GomezThiago123/LlaveTrack/README.md

# LlavesUBA

(Antes se llamaba LlaveTrack: los nombres internos, como la carpeta y los tópicos MQTT, siguen así.)

> Qué es y cómo funciona el sistema, y el estado de cada historia: [documentacion.md](documentacion.md). Tareas abiertas: [PENDIENTES.md](PENDIENTES.md).

Sistema para retirar y devolver las llaves de las aulas de la ETEC-UBA. El docente reserva la llave desde la web, ingresa un código en el equipo y un disco giratorio le entrega su llave. Cada llave tiene un tag RFID, así el sistema registra quién la retiró, quién la devolvió y a qué hora.

## Estructura

| Carpeta | Qué hay |
| --- | --- |
| `backend/` | API REST + MQTT en Python (FastAPI). Incluye `simulador/`, que se hace pasar por el equipo para probar sin hardware |
| `frontend/` | Aplicación web mobile-first (React + Vite + TypeScript) |
| `docs/` | Protocolo MQTT, cableado, user stories y [cómo subirlo a la nube](docs/despliegue.md) |
| `firmware/` | Programa del ESP32 (PlatformIO) |
| `deploy/`, `render.yaml` | Imagen y configuración para la nube |

El backend y el frontend son independientes: cada uno se instala y se levanta **en su propia terminal**.

## Backend

Requisito: **Python 3.11 o más nuevo** (`python3 --version`, en Windows `py --version`).
- Windows: instalador de [python.org](https://www.python.org/downloads/) marcando "Add python.exe to PATH".
- Linux Mint: viene instalado. Si falta el módulo de entornos virtuales: `sudo apt install python3-venv`.

### Primera vez

Linux:
```sh
cd backend
python3 -m venv .venv
source .venv/bin/activate
pip install -r requirements.txt
```

Windows (PowerShell):
```powershell
cd backend
py -m venv .venv
.venv\Scripts\Activate.ps1
pip install -r requirements.txt
```
Si PowerShell no deja activar el entorno, corré una sola vez `Set-ExecutionPolicy -Scope CurrentUser RemoteSigned`.

Después, con el entorno activado, creá la base de datos y cargá los datos iniciales (las 6 aulas con su llave y los usuarios de prueba de `seed/datos.json`):
```sh
alembic upgrade head
python -m app.seed
```

El archivo `.env` es opcional: sin él se usan los valores por defecto. Para cambiarlos, copiá `.env.example` a `.env`.

**Base en Supabase (opcional):** por defecto la base es un archivo SQLite local. Para usar la de Supabase, en el dashboard tocá **Connect** → **Session pooler**, copiá la URL y ponela en `backend/.env` como `DATABASE_URL`, cambiando `postgresql://` por `postgresql+psycopg://` (ejemplo en `.env.example`). Después corré `alembic upgrade head` y `python -m app.seed` como arriba. Ojo: es una sola base para todo el grupo, así que cualquier `--reiniciar` o migración afecta a todos.

### Cada vez

Activá el entorno virtual (`source .venv/bin/activate` en Linux, `.venv\Scripts\Activate.ps1` en Windows). Vas a ver `(.venv)` al principio de la línea. Después:

| Comando | Qué hace |
| --- | --- |
| `python run.py` | Levanta el servidor en `http://localhost:8000`. Se reinicia solo cuando cambiás el código |
| `pytest` | Corre los tests (usan una base temporal con `tests/datos_prueba.json` e ignoran tu `.env`: nunca tocan `llavetrack.db` ni Supabase) |
| `alembic upgrade head` | Aplica las migraciones pendientes a la base (correrlo después de cada `git pull`) |
| `python -m app.seed --reiniciar` | **Borra todos los datos** y vuelve a cargar `seed/datos.json` |
| `python -m app.cambiar_clave EMAIL` | Cambia la contraseña de un usuario, en la base que indique el `.env` |
| `python simulador/simulador.py` | Simulador del equipo (ver abajo) |

Con el servidor levantado, en `http://localhost:8000/docs` está la documentación interactiva de la API, que genera FastAPI. Para probar las rutas que piden login, primero ejecutá `POST /api/auth/login` ahí mismo: el navegador guarda la cookie de sesión y la manda en los pedidos siguientes.

### Usuarios de prueba

Los de `seed/datos.json`, todos con la contraseña `llavetrack`:

| Email | Rol |
| --- | --- |
| `ana.perez@example.com` | Docente |
| `bruno.gomez@example.com` | Docente |
| `carla.diaz@example.com` | Preceptora |
| `admin@example.com` | Administrador |

5 contraseñas incorrectas seguidas bloquean la cuenta 15 minutos. Para "Olvidé mi contraseña": si no configuraste un servidor de mail (`SMTP_*` en `.env`), el link de recuperación aparece en la terminal del servidor.

### MQTT y simulador del equipo

El servidor se conecta al broker **Mosquitto** en `localhost:1883` (Linux: `sudo apt install mosquitto mosquitto-clients`; Windows: instalador de [mosquitto.org](https://mosquitto.org/download/)). Si el broker no está, la API funciona igual y el servidor reintenta conectarse solo.

El simulador se hace pasar por el equipo (ESP32), así se puede probar todo sin hardware. Como el equipo real, **queda prendido** hasta que lo apagues: al arrancar se conecta, avisa que está en línea y después manda un "latido" cada 30 s. En otra terminal, desde `backend/` con el entorno activado:

```sh
python simulador/simulador.py
```

Los comandos se escriben en el prompt `equipo>`:

| Comando | Qué simula |
| --- | --- |
| `retirar 482913` | Ingresa el código de una reserva y retira la llave. El código es el que da la web |
| `timeout 482913` | Ingresa el código pero nadie retira la llave |
| `falla 482913` | Ingresa el código pero el equipo no encuentra la llave: el preceptor lo ve en "Problemas del equipo hoy" (US-05) |
| `devolver CAA8EA81` | Cuelga la llave con ese UID en el lugar vacío de la ventana |
| `desenchufar` | Corte de luz: deja de responder sin avisar. A los ~15 s el servidor lo ve desconectado |
| `enchufar` | Vuelve a arrancar después de `desenchufar` |
| `pantalla` | Muestra los dos LEDs (conexión y faltantes) y cómo rota el LCD en reposo |
| `salir` | Se apaga prolijo (también con Ctrl+C) y queda desconectado enseguida |

Muestra cada mensaje MQTT (`→` lo que manda el equipo, `←` lo que responde el servidor) y lo que mostraría el LCD. Con `--repetir` manda cada evento dos veces, para ver que el servidor no lo procesa dos veces. Los UID de las llaves están en `seed/datos.json` (la del 214 es `CAA8EA81`). Contra el broker de la nube: `python simulador/simulador.py --host xxxx.hivemq.cloud --tls --usuario equipo-01` (ver [docs/despliegue.md](docs/despliegue.md)). Con el equipo real prendido no uses el simulador: los dos se presentan como `equipo-01`.

Mientras el equipo está desconectado, la web no deja pedir llaves (US-22). El simulador también muestra los LEDs: el de faltantes se prende cuando hay llaves prestadas (US-23) y el de conexión titila si se cae el broker o el servidor; en ese caso no deja retirar ni devolver (US-24).

Para ver todos los mensajes del broker: `mosquitto_sub -v -t 'llavetrack/#'` o MQTTX.

## Frontend

Requisito: **Node.js 20.19 o más nuevo** (recomendado: 24 LTS). Verificalo con `node --version`.
- Windows: instalador de [nodejs.org](https://nodejs.org) o `winget install OpenJS.NodeJS.LTS`.
- Linux: con [nvm](https://github.com/nvm-sh/nvm), corré `nvm install` dentro de `frontend/` (lee la versión de `.nvmrc`).

```sh
cd frontend
npm install        # solo la primera vez, o cuando cambie package.json
npm run dev
```

La web queda en `http://localhost:5173` y se actualiza sola cuando cambiás el código. Todo lo que empieza con `/api` lo reenvía al backend (puerto 8000), así que **el backend tiene que estar levantado en otra terminal**. Si el backend corre en otro puerto: `LLAVETRACK_API=http://localhost:8001 npm run dev` (en PowerShell: `$env:LLAVETRACK_API="http://localhost:8001"; npm run dev`).

Para abrir la web **desde el celular**, conectalo a la misma red WiFi y entrá a `http://<IP-de-la-compu>:5173`. Vite muestra la IP en la terminal, en la línea `Network`. Si vas a probar "Olvidé mi contraseña" desde el celular, poné esa misma dirección en `WEB_URL` del `backend/.env`, así el link del mail apunta a la compu.

| Pantalla | Qué hay |
| --- | --- |
| `/` | Sin login: estado de cada aula y si el equipo está en línea |
| `/login`, `/recuperar`, `/restablecer` | Ingresar, recuperar la contraseña y crearla (el docente nuevo llega por el link del mail) |
| `/aulas` | Con login: buscador, peines y "solo disponibles"; quién tiene cada llave. Pedir una llave muestra el código arriba, con cuenta regresiva |
| `/mis-llaves` | Las llaves que tengo y mis préstamos anteriores (US-17) |
| `/cuenta` | Mis datos y cerrar sesión |
| `/faltantes` | Preceptor: llaves fuera del carrusel, contacto del docente y "Enviar recordatorio" (US-16) |
| `/historial` | Preceptor: retiros y devoluciones por aula, docente, fechas y estado (US-12/13) |
| `/equipo` | Preceptor: estado del equipo, carrusel, problemas de hoy (US-05) y tags RFID (US-10) |
| `/docentes` | Preceptor: cuentas bloqueadas (US-07), alta y desactivar docentes (US-09) |

Las pantallas se actualizan solas cada 5 segundos. El diseño sale del [prototipo de Joel](https://github.com/joel012930/llavetrack), con los colores de la UBA.

| Comando | Qué hace |
| --- | --- |
| `npm run dev` | Levanta la web en modo desarrollo |
| `npm run build` | Compila la web para producción (queda en `dist/`) |

## Firmware del equipo (ESP32)

Está en `firmware/` (PlatformIO). El cableado está en [docs/cableado.md](docs/cableado.md) y los pines y tiempos en `firmware/include/config.h`.

**Con VS Code** (lo más fácil): instalá la extensión **PlatformIO IDE**, abrí la carpeta `firmware/` (Archivo → Abrir carpeta) y conectá el ESP32 por USB. En la barra de abajo: la flecha **→** lo carga y el enchufe abre el Monitor Serie (115200 baudios). La primera vez tarda unos minutos porque baja las herramientas del ESP32.

**Si la compu no detecta la placa:** la NodeMCU usa el chip USB **CP2102**, que en Windows necesita el driver *CP210x* de Silicon Labs (silabs.com → USB to UART Bridge VCP Drivers; extraer el .zip y correr `CP210xVCPInstaller_x64`). Con el driver, aparece en el Administrador de dispositivos como *Silicon Labs CP210x USB to UART Bridge (COMx)*. Si ni así aparece, el cable es solo de carga: usar uno que pase datos. En **Linux** el driver ya viene y la placa aparece como `/dev/ttyUSB0`, pero hay que darle permiso al usuario una sola vez (después, desenchufar y volver a enchufar la placa):
```sh
echo 'SUBSYSTEMS=="usb", ATTRS{idVendor}=="10c4", ATTRS{idProduct}=="ea60", MODE="0666"' | sudo tee /etc/udev/rules.d/99-esp32-cp210x.rules && sudo udevadm control --reload-rules
```

**Desde la terminal**, con PlatformIO instalado con `pip install platformio` (el paquete `platformio` de apt no arranca en Linux Mint: da `AttributeError ... resultcallback`):
```sh
cd firmware
pio run -t upload     # compila y carga
pio device monitor    # Monitor Serie
```

**Antes de compilar**, copiá `firmware/include/secrets.example.h` como `secrets.h` (en la misma carpeta) y completalo con la WiFi y la IP de la compu donde corre Mosquitto. `secrets.h` no va al repo.

Al prender busca el tag HOME, se conecta a la WiFi y al broker, avisa al servidor (`inicio`) y deja un lugar vacío en la ventana. En reposo el LCD muestra la hora y las llaves que faltan; con **A** se retira y con **B** se devuelve. Por el Monitor Serie: `r` (estado de la red), `p` (dónde está el disco), `h` (homing de nuevo), `t A123456#` (simula esas teclas). **Al prender, el disco gira solo**: tené la mano cerca del interruptor la primera vez.

**Modo diagnóstico** (mantener **D** apretada al encender, sin red): escanea el bus I2C y se prueba el disco desde el Monitor Serie con `i 5` (ir al slot 5), `b 9AAFF281 1` (buscar la llave de la 101), `v 10` (dejar un lugar vacío) y `d` (qué tag hay en cada slot).

**Para que el ESP32 llegue a Mosquitto** (solo en una red privada, como el hotspot de un celular): crear `/etc/mosquitto/conf.d/llavetrack.conf` (en Windows, agregarlo al final de `mosquitto.conf`) con
```
listener 1883 0.0.0.0
allow_anonymous true
```
reiniciar Mosquitto y abrir el puerto 1883 en el firewall **solo para el ESP32** (el broker no tiene contraseña). En Linux, con la IP que muestra el Monitor Serie al conectarse a la WiFi: `sudo ufw allow from <IP-del-ESP32> to any port 1883 proto tcp`. En la demo el broker es HiveMQ Cloud, con TLS y contraseña (puerto 8883): ver [docs/despliegue.md](docs/despliegue.md).

Para probar cada pieza por separado está `firmware/prueba_arduino/prueba_arduino.ino` (Arduino IDE).
