GomezThiago123/LlaveTrack/(commit log)

2026-10-01 Fase 0: esqueleto del repo
    npm workspaces (server, web, tools/simulador), servidor Express con
    GET /api/salud y su test, web React + Vite mobile-first que muestra el
    estado del servidor, simulador con la ayuda, contrato MQTT en
    docs/protocolo-mqtt.md y README con como levantar todo.
2026-10-01 Fase 0: backend en Python (FastAPI)
    Reemplaza el servidor y el simulador en Node por Python: FastAPI con
    GET /api/salud y su test en pytest, configuracion con pydantic-settings
    y entorno virtual .venv con requirements.txt. scripts/setup.mjs y
    scripts/py.mjs hacen que npm run setup/dev/test funcionen igual en
    Windows y Linux. Actualiza CLAUDE.md y README con el nuevo stack.
2026-10-01 Fase 0: backend y frontend separados
    server/ pasa a backend/ (con su propio .venv, requirements.txt y el
    simulador) y web/ pasa a frontend/ (con su propio package.json). Se
    quitan el package.json raiz, los workspaces y scripts/: cada parte se
    instala y se levanta en su propia terminal. Actualiza CLAUDE.md, README
    y el contrato MQTT.
2026-10-01 Fase 1A: modelo de datos, migracion inicial y seed
    Las 7 tablas del MVP con SQLAlchemy (fechas siempre en UTC, indices
    unicos parciales para codigo y reserva pendiente por usuario), Alembic
    con la migracion inicial, seed desde seed/datos.json y base temporal
    para los tests. SQLite usa BEGIN IMMEDIATE para que los pedidos
    simultaneos se pongan en fila. Python minimo 3.11 (SQLAlchemy 2.1).
2026-10-01 US-03: reserva con vencimiento
    POST /api/reservas, GET /api/reservas/activa y DELETE /api/reservas/:id.
    Codigo de 6 digitos unico entre las pendientes, vence a los
    RESERVA_MINUTOS (10). La llave se toma con un UPDATE condicional y se
    verifica cuantas filas cambio; test con dos pedidos simultaneos en
    hilos. Maximo una reserva pendiente por docente. Errores con formato
    {error: {codigo, mensaje}}. Usuario TEMPORAL por encabezado
    X-Usuario-Email en modo desarrollo hasta el login (Fase 2).
2026-10-01 US-02: consultar aulas disponibles
    GET /api/publico/estado (sin login, sin datos personales, con equipo
    online) y GET /api/aulas (con login; preceptor y admin ven quien tiene
    o reservo cada llave y su telefono). Las reservas vencidas se liberan
    antes de cada consulta. No se muestran llaves dadas de baja.
2026-10-01 US-04, US-05, US-06: retiro y devolucion por MQTT
    El servidor se conecta a Mosquitto con paho-mqtt (en su propio hilo,
    reconexion automatica) y procesa los eventos del equipo: inicio,
    solicitud_retiro, retiro_confirmado, retiro_timeout, devolucion, error
    y el estado online/offline (LWT). Cada evento se valida con Pydantic y
    se guarda con su respuesta en la misma transaccion; un eventId repetido
    recibe la misma respuesta sin procesarse de nuevo. Los rechazos deshacen
    solo lo del evento (savepoint). Al aceptar un codigo la reserva se
    extiende RETIRO_MARGEN_SEGUNDOS. slotReposo = slot vacio mas cercano.
2026-10-01 Fase 1B: simulador del equipo y documentacion
    Simulador que se hace pasar por el ESP32: inicio, retirar, timeout,
    devolver y offline, con eventId unicos, reintentos cada 5 s, LWT y
    --repetir para probar duplicados; muestra el LCD simulado. Contrato
    MQTT actualizado con lo implementado (DATOS_INVALIDOS, margen de
    retiro, slotReposo), README con el uso y decisiones en CLAUDE.md.
2026-10-20 US-01, US-07, US-08: login con contraseña, bloqueo y recuperación
    - Sesión en cookie httpOnly que vence tras 15 min sin actividad
    - 5 intentos fallidos bloquean la cuenta 15 min
    - Link de recuperación por mail (smtplib) que vence en 30 min y sirve una vez;
    sin SMTP configurado se muestra en la consola del servidor
    - Se borra el encabezado temporal X-Usuario-Email y MODO_DESARROLLO
2026-10-20 US-01, US-03: refrescos automáticos no renuevan la sesión y consulta de una reserva
    - Encabezado X-Refresco-Automatico: los pedidos que la web hace sola cada 5 s
    no cuentan como actividad (si no, la sesión nunca vencería con la web abierta)
    - GET /api/reservas/:id para que la web sepa si la llave ya se retiró
2026-10-20 US-01, US-02, US-03: web mobile-first
    - Vista pública de disponibilidad y estado del equipo
    - Login, recuperar y restablecer contraseña
    - Lista de aulas con refresco cada 5 s; preceptores ven quién tiene cada llave
    - Código grande con cuenta regresiva que sobrevive a recargar la página
2026-10-20 US-20: no se puede reservar con el equipo desconectado
    - Equipo online = último estado online y contacto hace menos de
    EQUIPO_TIMEOUT_SEGUNDOS (90); nuevo tópico latido cada 30 s
    - El servidor marca los equipos offline al conectarse y desconectarse del
    broker y recupera el estado retenido al suscribirse
    - POST /api/reservas responde 409 EQUIPO_DESCONECTADO; la reserva pendiente
    no se cancela si el equipo se cae
    - Web: Pedir llave deshabilitado y aviso en la pantalla del código
    - Simulador interactivo con LWT, latido, desenchufar y enchufar
2026-10-20 Docs: respuestas de hardware (32 slots, placa, LCD, tag HOME) y servidor en la nube
2026-10-20 US-21: aulas faltantes por MQTT retenido
    - El servidor publica faltantes {"aulas":[...]} (llaves PRESTADAS) retenido al
    cambiar, al responder inicio y al conectarse al broker
    - Simulador: LED de faltantes, rotación del LCD en reposo y comando pantalla
    - Regla de las pantallas del LCD documentada y con tests
2026-10-20 US-22: estado del servidor con LWT
    - El servidor publica llavetrack/v1/servidor/estado retenido, con LWT, y
    ignora su propio estado en el patrón +/estado (deviceId servidor reservado)
    - Simulador: LED de conexión (titila sin broker o sin servidor), LCD con la
    causa y no entrega ni recibe llaves sin conexión
    - Tests de LWT con corte de socket en vez de esperar el keepalive (eran inestables)
2026-10-20 Infra: base PostgreSQL en Supabase
    - Driver psycopg y pool_pre_ping para el pooler de Supabase
    - Migracion que activa RLS en todas las tablas (solo en PostgreSQL)
    - Ejemplo de DATABASE_URL en .env.example y pasos en el README
    - Lista de las 30 aulas reales rescatada de las tablas viejas
    - CLAUDE.md y PENDIENTES.md al dia
2026-10-20 Seed: 30 aulas reales
    - seed/datos.json con las 30 aulas en los slots 1-30 de un disco de 32 (0 = HOME)
    - UID inventados (04A0 + aula) hasta tener los reales del modo diagnostico
    - Los tests usan tests/datos_prueba.json e ignoran el .env (LLAVETRACK_TESTS)
    - Test que valida el seed real (UID y slots unicos, ningun slot reservado)
    - Simulador con 32 slots por defecto
2026-10-20 Docs: user stories de Notion y decisiones sobre los criterios
2026-10-20 US-03: la reserva vence a los 2 minutos
2026-10-20 US-01: la sesion se cierra a los 60 s sin actividad
    Salvo en la pantalla del codigo: su consulta de la reserva renueva la sesion
    mientras el docente va al equipo.
2026-10-20 US-02: todos los usuarios ven quien tiene cada llave
    Nombre, hora y telefono, para docentes, preceptores y admin. La vista publica sigue sin datos personales.
2026-10-20 US-07: el preceptor desbloquea cuentas antes de los 15 minutos
    GET /api/usuarios/bloqueados y POST /api/usuarios/:id/desbloquear, solo para preceptor y admin.
    En la web, cuadro "Cuentas bloqueadas" arriba de la lista de aulas.
2026-10-20 Textos de la web y del LCD segun los criterios de aceptacion
    US-01 "Usuario o contraseña incorrectos", US-02 "Ocupada", US-07 "Cuenta bloqueada temporalmente",
    US-08 "Si el email está registrado, te enviamos un link". LCD del simulador: US-04 "Aula X servida /
    RETIRE SU LLAVE" y "Gracias", US-06 "Llave de aula / X recibida". Los del firmware van al CLAUDE.md.
2026-10-20 Docs: US-20/21/22 del codigo pasan a ser US-22/23/24, como en Notion
    En Notion, US-20 y US-21 son otras historias (V2). Las tres nuevas se cargaron en el
    backlog de Notion como MVP. Los commits anteriores siguen diciendo US-20/21/22.
2026-10-20 Docs: devolucion automatica (US-06) y motor de 2 cables visto en la foto
2026-10-20 Docs: motor de 24 V y 2 cables (no es paso a paso)
2026-10-20 Docs: motor de continua confirmado y correcciones del diagrama de bloques
2026-10-20 US-05: incidentes del equipo visibles para el preceptor
    - evt/error con el codigo de la reserva crea un Incidente (aula y docente)
    - Tabla incidente (migracion con RLS para Supabase)
    - GET /api/incidentes (preceptor y admin): los de hoy, hora de Argentina
    - Cuadro "Problemas del equipo hoy" en la lista de aulas del preceptor
    - Simulador: comando falla CODIGO
    - LCD "Reposicionando" / "Espere..." (el texto de la US no entra en 16 caracteres)
2026-10-20 Docs: el equipo usa la WiFi de la escuela (WPA2-Enterprise)
2026-10-20 Docs: el servidor de la demo tiene que estar en la region de Supabase (latencia medida)
2026-10-20 V2 (servidor): mis prestamos, historial, recordatorio, docentes y tags RFID
    - US-17: GET /api/prestamos/mios
    - US-12/13: GET /api/prestamos con filtros (aula, docente, dias, estado) y llaves en poder
    - US-16: POST /api/prestamos/:id/recordatorio (mail; manual, el sistema no conoce los turnos)
    - US-09: GET/POST /api/usuarios y PATCH /api/usuarios/:id (alta con mail para crear la clave, desactivar)
    - US-10: GET /api/equipo y PUT /api/llaves/:id/rfid (UID a mano hasta el modo alta del equipo)
    - /api/auth/yo trae el telefono; el tenedor de cada aula trae su usuarioId
2026-10-20 Reservas: la respuesta trae creadaEn (para la barra de tiempo de la web)
2026-10-20 WIP: rediseño de la web con el prototipo y los colores de la UBA (sin terminar)
    Hecho: estilos (index.css), componentes comunes, api.ts, Aulas, tarjeta de reserva, Mis llaves,
    Cuenta, Faltantes, Historial, Equipo y Docentes.
    Falta: rutas en App.tsx, adaptar Login, Recuperar e Inicio, sacar Codigo.tsx, probar.
    Todavia no compila: no mergear a main.
2026-10-20 Docs: PENDIENTES.md con el rediseño en curso y las V2 del servidor
2026-10-21 Web: rediseño con el prototipo y los colores de la UBA, con las pantallas de V2
    - Login, recuperar, vista publica y Aulas (buscador, pisos, grilla de a dos, codigo arriba)
    - Docente: Mis llaves (US-17) y Cuenta
    - Preceptor: Faltantes con recordatorio (US-16), Historial (US-12/13), Equipo con carrusel
    y tags RFID (US-10), Docentes con alta y desactivar (US-09)
    - vite.config.ts: LLAVETRACK_API para apuntar a otro puerto del servidor
    - Probado con capturas en tamano de celular (Chrome headless)
2026-10-21 Web: Vite 8.3.3 (corrige la falla de seguridad de 8.3.2)
2026-10-21 Servidor: las listas traen aula y docente en la misma consulta
    Con Supabase desde Argentina cada consulta tarda ~170 ms. /api/aulas hacia 35 (6,7 s) y
    /api/equipo 37 (7,7 s), y la web se quedaba en "Cargando...". Ahora hacen 5 y 7.
    Test nuevo: ninguna lista pasa de 10 consultas.
2026-10-21 Docs: US-06 ajustada (la devolucion se confirma sola) y PENDIENTES al dia
2026-10-21 Docs: documentacion.md (como funciona, conexiones, UID de las llaves, estado de las US)
2026-10-27 Seed: 5 llaves con sus UID reales (pedido del profe)
    101, 102, 213, 214 y 313 en los slots 1 a 5. Las 30 aulas quedan en seed/datos_30_aulas.json.
2026-10-27 Docs: la posicion del disco sale del RFID y el tiempo de giro (plan A)
2026-10-27 Firmware: programa de prueba del hardware para el Arduino IDE
    LCD + scanner I2C, RC522 (muestra el aula de cada tag conocido), teclado, LEDs, motor y
    medicion del tiempo de una vuelta con el tag HOME. Pines: la propuesta del 27/10/2026.
2026-10-27 Firmware: el programa de prueba usa el cableado real (docs/cableado.md)
    Pines relevados del codigo de los companeros: RC522 RST 27, motor IN3/IN4 25/26 sin PWM,
    teclado 4,13,14,16 / 17,32,33,2 y un LED bicolor en 12/15.
2026-10-27 Docs: el proyecto queda con las 5 llaves (se descartan las otras 25)
2026-10-27 Web: los grupos de aulas se llaman "Peine" en vez de "Piso"
2026-10-27 Docs: PENDIENTES y documentacion al dia (plan de la Fase 3 esperando OK)
2026-10-27 Fase 3, paso 1: firmware del disco sin red (homing con HOME, buscar llave, lugar vacio)
    Proyecto PlatformIO con versiones fijas (espressif32 7.1.3). Modulos lcd, teclado, rfid (lee varios
    tags a la vez y ve los que siguen presentes), motor, led y disco (posicion por tiempo, corregida con el
    HOME; centra la llave pedida al verla). El main es un modo de prueba por el Monitor Serie y el teclado.
    CLAUDE.md: la seccion Firmware ahora describe el motor de continua.
2026-10-27 Firmware: el Monitor Serie muestra lo que se escribe
2026-10-27 Docs: estado del firmware (falta cargarlo por el cable USB) y driver CP210x
2026-11-03 Fase 3, paso 2a: WiFi y MQTT en el firmware (US-22, US-23, US-24)
    - red: WiFi comun o WPA2-Enterprise, MQTT con LWT, estado retenido, latido y
    reconexion solo con el disco quieto; hora por NTP.
    - protocolo: eventId por arranque, reintento con el mismo eventId, faltantes
    y comando recalibrar.
    - main: homing, inicio y lugar vacio; LCD de reposo con la hora y las llaves
    que faltan; LED segun la conexion.
    - El programa del paso 1 pasa a ser el modo diagnostico (D al encender).
    - secrets.example.h; docs al dia.
2026-11-03 Fase 3, paso 1: vuelta de 42 s y diagnostico del tag que ya estaba en la ventana
    Resultado de la prueba en el equipo real (03/11/2026):
    - La vuelta tarda 42 s, no 25: con el timeout de 40 s el homing fallaba
    justo antes de ver el HOME por segunda vez. Ahora es vuelta y media.
    - El diagnostico ignora el tag que ya estaba en la ventana al empezar (no se
    lo vio entrar: su centro salia corrido) y gira dos tags mas para anotarlo
    en su segunda pasada.
    - En el modo diagnostico se imprime cada tag que entra y sale del lector.
2026-11-03 Fase 3, paso 1: holgura del disco al invertir el sentido
    En el equipo real (03/11/2026), al girar para atras despues de ir para
    adelante, todos los tags entraron ~0,85 slot antes de lo esperado (offset
    constante: juego de los engranajes, no otra velocidad). Al buscar el HOME
    desde el slot 5 frenaba en el 0,9, no lo veia y tardaba 13 s en encontrarlo.
    HOLGURA_REVERSA_SLOTS (config.h, provisorio): al cambiar de sentido, ese
    tramo no mueve la posicion estimada ni descuenta distancia.
2026-11-03 Fase 3: el tag HOME es A94B37A4 (9A35EA81 es la llave de la 104)
    Thiago leyo cada tag el 03/11/2026. Mapa real: HOME A94B37A4, 101 9AAFF281,
    102 2A86C880, 104 9A35EA81, 213 5A81F281, 214 CAA8EA81, 313 2AC3FE80.
    Corregido en config.h, en el ejemplo del modo diagnostico y en la tabla
    del programa de prueba (prueba_arduino). El seed y los docs van aparte.
2026-11-03 Fase 3, paso 1: margen al buscar una llave (la velocidad del disco deriva)
    Prueba del 03/11/2026: la vuelta dio 42 y 46,4 s en dos corridas, y dentro
    de una misma sesion deriva ~0,5 slot por vuelta. Con la estimacion
    adelantada, el disco frenaba con la llave al borde del lector, no la veia y
    probaba los vecinos (10-15 s mas).
    - BUSCAR_MARGEN_SLOTS (0,6): si al llegar al slot esperado la llave no
    aparecio, sigue ese tramo; si entra, se centra como antes.
    - VUELTA_MS_INICIAL = 46000 (el mas lento: de ahi sale el timeout del homing).
    - HOLGURA_REVERSA_SLOTS = 0,85 confirmada (error ~0,15 slot).
2026-11-03 Fase 3, paso 1: sentido del disco con el orden definitivo de las llaves
    Thiago colgo las llaves en su lugar definitivo (03/11/2026). Girando
    adelante pasan 313, 213, 214, 102, 104, 101 y el HOME: con
    ADELANTE_SUMA_SLOTS = false quedan 101=1, 104=2, 102=3, 214=4, 213=5, 313=6.
2026-11-03 Fase 3, paso 1: probado en el equipo; las 6 llaves reales en el seed y los docs al dia
    El HOME es A94B37A4 (9A35EA81 es la llave de la 104, que se suma: 6 llaves).
    Slots 1 a 6 en el orden en que quedaron colgadas: 101, 104, 102, 214, 213, 313.
    Supabase se actualizo a mano con SQL (y se cerraron dos prestamos de prueba).
    Docs: vuelta de 42 a 47 s (no 25), LCD en 0x27, holgura al invertir el giro,
    margen al buscar, y como dar permiso al puerto USB en Linux.
2026-11-03 Fase 3, paso 1: la llave frena centrada (no hace falta control de velocidad)
2026-11-03 Fase 3, paso 2a: probado en el equipo con PEINE-3 (US-22, US-24)
    El equipo se conecta a la WiFi y al broker de la notebook, manda inicio y deja
    el lugar vacio que dice el servidor. Si el servidor se cae, el LCD lo muestra en
    el mismo segundo y se recupera solo. Docs: Mosquitto con listener en la red y
    el firewall abierto solo para la IP del ESP32; PEINE-3 como WiFi de desarrollo.
2026-11-03 Fase 3, paso 2b: retiro y devolucion en el equipo real (US-04, US-05, US-06)
    Tecla A: codigo (* borra, # confirma, C cancela), el servidor lo valida, el disco
    busca la llave por su UID y la deja en la ventana; al sacarla, retiro_confirmado.
    Si no aparece, homing y otra busqueda (intento 2) y si no, 'Pedi la llave en
    porteria' con el incidente. 3 codigos mal bloquean el teclado 30 s; 60 s sin
    sacarla, retiro_timeout. Tecla B: la llave colgada estable 1 s -> devolucion.
    Probado en el equipo el retiro y la devolucion de la 214.
2026-11-03 Crear dominio propio,subir en la nube
2026-11-03 Nube: comando para cambiar contrasenas antes de la demo
2026-11-03 Nube: simulador con TLS y usuario, para probar contra el broker real
2026-11-03 US-24: la imagen de la nube se apaga prolija y avisa enseguida
2026-11-03 Nube: guia de despliegue gratis y documentacion al dia
2026-11-04 US-04: una llave sacada justo antes de los 60 s se registra como retiro
    Si la llave ya no se ve, primero se confirma el retiro; recien con la llave
    todavia en la ventana se da por agotado el tiempo.
2026-11-04 US-01: la sesion no vence mientras hay una reserva pendiente
    Con el celular bloqueado camino al equipo la web no pide nada; al desbloquearlo
    el docente tiene que seguir viendo el codigo, no el login.
2026-11-04 Equipo: boton Recalibrar el disco para el preceptor
    POST /api/equipo/recalibrar publica el comando recalibrar en el topico cmd del
    equipo (el firmware ya lo atendia). Docs al dia con los tres arreglos.
2026-11-04 Firmware: trazas del lector en el modo normal (comando trazas)
    Cada tag que entra y sale con la posicion estimada, para ajustar el equipo.
2026-11-04 Fase 3, paso 2b: casos que salen mal probados en el equipo; llaves en orden
    Probados con el equipo real: 3 codigos mal, llave no reconocida, tiempo agotado,
    B con la llave ya colgada, recalibrar desde la web y US-05 (llave que falta).
    El motor gira al reves y al doble que el 03/11: ADELANTE_SUMA_SLOTS = true.
    Llaves recolgadas en orden: 101, 102, 104, 213, 214, 313 (slots 1 a 6).
2026-11-04 LED: naranja con rojo fijo y verde al 25%; comandos led y ledinfo
    El LED tiene 3 patas y los pines hacen lo esperado, pero el naranja no se ve:
    queda en pausa (no es prioritario) hasta revisar la conexion de la pata comun.
2026-11-04 Nube: las cuentas y el despliegue los hacen los superiores
2026-11-04 US-21: incidentes resueltos y aula En revision
    Mientras un incidente con aula esta abierto, el aula figura EN_REVISION y no se
    puede reservar (409 AULA_EN_REVISION). El preceptor lo marca resuelto desde la
    web (POST /api/incidentes/:id/resolver). La lista muestra los abiertos de
    cualquier dia y los resueltos hoy. Migracion: resuelto_en y resuelto_por_id.
2026-11-04 US-11: dar de baja una llave perdida y reponerla
    POST /api/llaves/:id/baja con un motivo: la llave pasa a BAJA y deja de aparecer
    para retiro; su prestamo abierto se cierra como perdido y su reserva se cancela.
    Queda la constancia (tabla baja_llave, con el ultimo docente) en el historial.
    Se repone con el tag nuevo y el lugar del disco (PUT /api/llaves/:id/rfid).
2026-11-04 US-19: exportar el historial a Excel
    GET /api/prestamos/exportar con los mismos filtros del historial devuelve un
    .xlsx (openpyxl 3.1.5): aula, docente, email, retiro, devolucion, duracion y
    estado, en hora de Argentina. Boton Exportar a Excel en el historial,
    deshabilitado si no hay movimientos.
2026-11-04 US-16: recordatorio automatico con la hora fin que dice el docente
    Al pedir la llave, la web pregunta hasta que hora se usa el aula (horaFin).
    Un hilo del servidor (app/tareas.py) revisa cada minuto y manda el mail 15 min
    despues si la llave sigue sin devolver; a los 60 min el prestamo figura
    Demorada en Faltantes. Migracion: hora_fin en reserva y prestamo, y
    aviso_automatico_en.
2026-11-04 Servidor: protocolo para US-10, US-14, US-15, US-18 y US-20
    - US-18: solicitud_retiro acepta dni en lugar del codigo; la respuesta trae
    codigo y nombre. Usuario.dni (indice unico), en el alta y el PATCH.
    - US-20: devolucion con dni de otro docente -> CONFIRMAR_TERCERO (con aula y
    quien la retiro); con confirmada=true queda devuelto_por y se le avisa por
    mail a quien la tenia (despues del commit).
    - US-14: devolucion con devueltoEn (hora del equipo), si es razonable.
    - US-15: evento retiro_interrumpido: cancela la reserva pendiente.
    - US-10: comando modo_alta, evento tag_leido (queda en el dispositivo y se ve
    en GET /api/equipo) y POST /api/llaves para asociar el tag a un aula.
    Co-Au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
2026-11-04 Web: DNI del docente, modo alta y devuelta por terceros (US-18, US-10, US-20)
    Docentes: DNI en el alta y en cada fila. Equipo: boton de modo alta, el tag
    leido y el formulario para asociarlo a un aula. Mis llaves e Historial: quien
    la devolvio si fue otro docente.
2026-11-04 Firmware: US-10, US-14, US-15, US-18 y US-20; docs al dia
    - US-18: A acepta el codigo (6) o el DNI (7 u 8); con DNI, "Hola Ana / Aula X".
    - US-20: con B se puede escribir el DNI y #; si la llave era de otro,
    "Retirada por Perez #=OK" y con # se confirma.
    - US-15: modulo memoria (Preferences): el retiro en curso queda en la flash;
    al volver la luz se manda retiro_interrumpido y el LCD dice Equipo listo.
    - US-14: B sin conexion guarda la devolucion con su hora y busca un lugar
    vacio probando los de al lado; al volver la red se manda con devueltoEn.
    - US-10: comando modo_alta y evento tag_leido.
    Compila; falta probarlo con el equipo real (PENDIENTES.md).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
2026-11-04 Web: al iniciar sesion se arranca en Aulas
    Pedido de los superiores (05/11/2026): despues del login siempre Aulas, y con
    la sesion abierta la pagina principal lleva directo ahi.
2026-11-04 Servidor: entrega directa desde la web y teclado con DNI + aula
    Pedido de los superiores (05/11/2026):
    - POST /api/reservas manda al equipo el comando entregar con el codigo
    interno de la reserva; si no sale, la reserva se cancela (503 SIN_BROKER).
    - solicitud_retiro acepta {dni, aula}: el docente que olvido el celular
    reserva en el teclado y el equipo la entrega en el momento (si ya tenia esa
    aula reservada, se usa esa reserva).
2026-11-04 Entrega directa y teclado con DNI + aula (firmware y web)
    Firmware: el comando entregar arranca el retiro solo (espera a que el equipo
    este en reposo); A ahora pide DNI y despues el aula. La web ya no muestra un
    codigo: dice que el equipo esta sacando la llave y pide estar frente al equipo.
2026-11-04 El sistema se llama LlavesUBA
    Pedido de los superiores (05/11/2026). Cambia lo que se ve: la web, el LCD,
    los mails y el simulador. Los nombres internos (topicos MQTT llavetrack/v1, la
    cookie, la carpeta del repo) quedan igual para no romper lo que anda.
2026-11-04 Docs: entrega directa y teclado con DNI + aula probados con el equipo
2026-11-04 Docs: Supabase migrada a la ultima version y en uso
